CREA-ETSIDI/ControlSystem_Regulacion/README.md

# ControlSystem_Regulacion
Proyecto de un coche que mantiene una distancia de referencia mediante sistemas de control usando Arduino para la asignatura de Regulación Automática
